if-zero-123/flyctrol/BOM_NAZE32飞控_NAZE32飞控_2026-05-23.xlsx

No. | Quantity | Comment | Designator | Footprint | Value | Manufacturer Part | Manufacturer | Supplier Part | Supplier
1 | 2 | 100nF | C1,C2 | C0603 | 100nF
2 | 2 | 20pF | C3,C7 | C0603 |  | CL10C220JB8NNNC | SAMSUNG | C1653 | LCSC
3 | 2 | 22uF | C4,C5 | C0603 | 22uF
4 | 8 | 0.1uF | C6,C22,C23,C24,C25,C26,C34,C42 | C0603 |  | AC0603KRX7R9BB104 | YAGEO | C149620 | LCSC
5 | 5 | 1uF | C27,C28,C30,C32,C33 | C0603 |  | CC0603KRX5R8BB105 | YAGEO | C14664 | LCSC
6 | 2 | 10uF | C29,C31 | C0603
7 | 1 | 0.01uF | C38 | C0603
8 | 2 | 0.1uF | C39,C41 | C0603
9 | 1 | 2.2nF | C40 | C0603
10 | 4 | PH1250-LT-02 | CN1,CN3,CN4,CN6 | CONN-SMD_2P-P1.25_PH1250-LT-02 |  | PH1250-LT-02 | HOOYA(皓宇电子) | C2939426 | LCSC
11 | 1 | 1.25MM-4P | CN2 | 4P-1.27MM |  | 1.25T-4PVertical patch | BOOMELE | C47608 | LCSC
12 | 1 | BAT54C | D2 | SOT-23-3_L2.9-W1.6-P1.90-LS2.8-BR |  | BAT54C(L43) | SEMTECH | C118748 | LCSC
13 | 1 | 4.7uH | L1 | IND-SMD_L4.6-W4.1-A | 4.7uH | SRG0420-4R7-M | JIERR(捷而瑞) | C53462918 | LCSC
14 | 1 | LED-0603_B | LED4 | LED0603_BLUE |  | 19-217/BHC-ZL1M2RY/3T | EVERLIGHT(台湾亿光) | C72041 | LCSC
15 | 1 | LED-0603_G | LED5 | LED0603_GREEN |  | NCD0805G1 | 国星光电 | C84260
16 | 1 | LED-0603_R | LED6 | LED0603_RED |  | 19-217/R6C-AL1M2VY/3T | EVERLIGHT(台湾亿光) | C72044 | LCSC
17 | 4 | IRLML6344 | Q1,Q2,Q3,Q5 | SOT-23-3_L3.0-W1.7-P0.95-LS2.9-BR |  | IRLML6344 | Hottech(合科泰) | C5364313 | LCSC
18 | 4 | 100K | R1,R3,R5,R7 | R0603 | 100K
19 | 4 | 100 | R2,R4,R6,R8 | R0603 | 100
20 | 4 | 10k | R18,R19,R23,R28 | R0603
21 | 3 | 4K7 | R25,R26,R27 | R0603
22 | 1 | 100k | R29 | R0603
23 | 3 | 1k | R30,R31,R32 | R0603
24 | 1 | Key_SMD_3x4x2 | SW1 | Key_SMD_3x4x2
25 | 4 | M3铜柱 | TP5,TP6,TP7,TP8 | M3铜柱_LCEDA |  |  |  |  | LCSC
26 | 1 | AP63205WU-7 | U1 | TSOT-23-6_L2.9-W1.6-P0.95-LS2.8-BL |  | AP63205WU-7 | DIODES(美台) | C2071056 | LCSC
27 | 1 | ZX-XH2.54-3PWZ | U3 | HDR-TH_3P-P2.50_ZX-XH2.54-3PWZ |  | ZX-XH2.54-3PWZ | Megastar(兆星) | C7429642 | LCSC
28 | 1 | CH340C | U4 | SOP-16_L10.0-W3.9-P1.27-LS6.0-BL |  | CH340C | WCH(南京沁恒) | C84681 | LCSC
29 | 1 | ZX-SH1.0-4PWT | U5 | CONN-SMD_4P-P1.00_MEGASTAR_ZX-SH1.0-4PWT |  | ZX-SH1.0-4PWT | Megastar(兆星) | C7430446 | LCSC
30 | 1 | STM32F103C8T6 | U9 | LQFP-48_L7.0-W7.0-P0.50-LS9.0-BL |  | STM32F103C8T6 | STMicroelectronics | C8734 | LCSC
31 | 2 | RT9013-33GB | U11,U13 | SOT-23-5_L3.0-W1.7-P0.95-LS2.8-BR |  | RT9013-33GB | RICHTEK | C47773 | LCSC
32 | 1 | BMP280 | U12 | SENSOR-TH_BMP280-BL |  | BMP280 | Bosch | C83291 | LCSC
33 | 1 | MPU6050 | U15 | QFN50P400X400X95-25T265X275N
34 | 1 | TYPE-C-16P | USB2 | USB-C-SMD_TYPE-C16PIN |  | TYPE-C16PIN | SHOU HAN | C393939 | LCSC
35 | 1 | 8MHz | X2 | OSC-SMD_3P-L3.2-W1.3-P1.2-L |  | CSTCE8M00G52-R0 | MuRata | C22549 | LCSC
