if-zero-123/flyctrol/SCH_NAZE32飞控_2026-05-23.pdf

3.3V

## GND

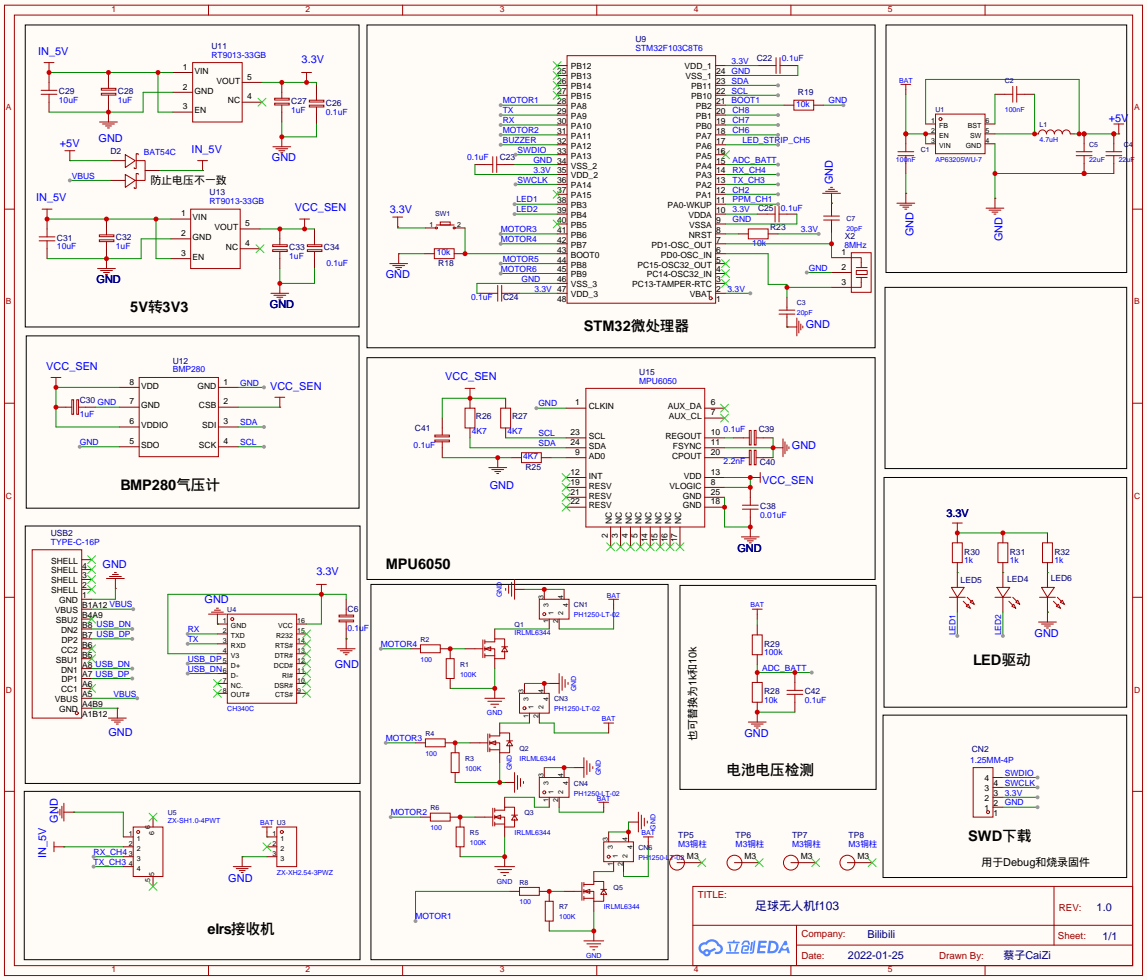
[picture p1: page 1]
