if-zero-123/flyctrol/Core/Src/main.c

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
/* Includes ------------------------------------------------------------------*/
#include "main.h"
/* USER CODE BEGIN Includes */
#include <string.h>
#include "FreeRTOS.h"
#include "task.h"
#include "app_main.h"
/* USER CODE END Includes */

ADC_HandleTypeDef hadc1;

I2C_HandleTypeDef hi2c2;

TIM_HandleTypeDef htim1;
TIM_HandleTypeDef htim4;

UART_HandleTypeDef huart1;
UART_HandleTypeDef huart2;
DMA_HandleTypeDef hdma_usart2_rx;
void SystemClock_Config(void);
static void MX_GPIO_Init(void);
static void MX_DMA_Init(void);
static void MX_ADC1_Init(void);
static void MX_I2C2_Init(void);
static void MX_TIM1_Init(void);
static void MX_TIM4_Init(void);
static void MX_USART1_UART_Init(void);
static void MX_USART2_UART_Init(void);
/* USER CODE BEGIN PFP */
static void StartupTask(void *argument);

/* USER CODE END PFP */

/* USER CODE BEGIN 0 */
static volatile uint32_t s_boot_stage;
static volatile uint32_t s_clock_hsi_fallback;

static void EarlyUart1_InitBare(void)
{
  uint32_t pclk;

  RCC->APB2ENR |= RCC_APB2ENR_AFIOEN | RCC_APB2ENR_IOPAEN | RCC_APB2ENR_USART1EN;

  GPIOA->CRH &= ~((0xFU << 4U) | (0xFU << 8U));
  GPIOA->CRH |= (0xBU << 4U) | (0x4U << 8U); /* PA9 AF_PP, PA10 floating input */

  USART1->CR1 = 0U;
  pclk = HAL_RCC_GetPCLK2Freq();
  if (pclk < 1000000U)
  {
    pclk = 8000000U;
  }
  USART1->BRR = (pclk + (115200U / 2U)) / 115200U;
  USART1->CR1 = USART_CR1_TE | USART_CR1_RE | USART_CR1_UE;
}

static void EarlyUart1_WriteString(const char *text)
{
  if (text == NULL)
  {
    return;
  }
  while (*text != '\0')
  {
    while ((USART1->SR & USART_SR_TXE) == 0U)
    {
    }
    USART1->DR = (uint16_t)(uint8_t)(*text++);
  }
  while ((USART1->SR & USART_SR_TC) == 0U)
  {
  }
}

static void EarlyDelay(volatile uint32_t loops)
{
  while (loops-- > 0U)
  {
  }
}

static void EarlyLed_InitBare(void)
{
  RCC->APB2ENR |= RCC_APB2ENR_AFIOEN | RCC_APB2ENR_IOPBEN;
  MODIFY_REG(AFIO->MAPR, AFIO_MAPR_SWJ_CFG, AFIO_MAPR_SWJ_CFG_JTAGDISABLE);

  GPIOB->CRL &= ~((0xFU << (3U * 4U)) | (0xFU << (4U * 4U)));
  GPIOB->CRL |= (0x2U << (3U * 4U)) | (0x2U << (4U * 4U)); /* output push-pull 2 MHz */
  GPIOB->BSRR = GPIO_PIN_3 | GPIO_PIN_4;                   /* active-low LEDs off */
}

static void EarlyLed_Set(uint16_t pin, uint32_t on)
{
  GPIOB->BSRR = (on != 0U) ? ((uint32_t)pin << 16U) : pin;
}

static void EarlyLed_BootFlash(void)
{
  for (uint32_t i = 0U; i < 4U; i++)
  {
    EarlyLed_Set(GPIO_PIN_3, 1U);
    EarlyLed_Set(GPIO_PIN_4, 1U);
    EarlyDelay(700000U);
    EarlyLed_Set(GPIO_PIN_3, 0U);
    EarlyLed_Set(GPIO_PIN_4, 0U);
    EarlyDelay(700000U);
  }
}

static void EarlyLed_ClockFlash(void)
{
  for (uint32_t i = 0U; i < 4U; i++)
  {
    EarlyLed_Set(GPIO_PIN_3, 1U);
    EarlyLed_Set(GPIO_PIN_4, 0U);
    EarlyDelay(500000U);
    EarlyLed_Set(GPIO_PIN_3, 0U);
    EarlyLed_Set(GPIO_PIN_4, 1U);
    EarlyDelay(500000U);
  }
  EarlyLed_Set(GPIO_PIN_3, 0U);
  EarlyLed_Set(GPIO_PIN_4, 0U);
}

static void EarlyLed_ClockResultHold(uint32_t hsi_fallback)
{
  uint16_t on_pin = (hsi_fallback != 0U) ? GPIO_PIN_3 : GPIO_PIN_4;
  uint16_t off_pin = (hsi_fallback != 0U) ? GPIO_PIN_4 : GPIO_PIN_3;

  EarlyDelay(1200000U);
  EarlyLed_Set(on_pin, 1U);
  EarlyLed_Set(off_pin, 0U);
  for (uint32_t i = 0U; i < 8U; i++)
  {
    EarlyDelay(1000000U);
  }
  EarlyLed_Set(on_pin, 0U);
  EarlyDelay(1200000U);
}

static void EarlyLed_ErrorCode(uint32_t code)
{
  uint32_t tens = code / 10U;
  uint32_t ones = code % 10U;

  EarlyLed_Set(GPIO_PIN_3, 0U);
  EarlyLed_Set(GPIO_PIN_4, 0U);
  EarlyDelay(2500000U);

  for (uint32_t i = 0U; i < tens; i++)
  {
    EarlyLed_Set(GPIO_PIN_4, 1U);
    EarlyDelay(700000U);
    EarlyLed_Set(GPIO_PIN_4, 0U);
    EarlyDelay(700000U);
  }

  EarlyDelay(1400000U);

  for (uint32_t i = 0U; i < ones; i++)
  {
    EarlyLed_Set(GPIO_PIN_3, 1U);
    EarlyDelay(700000U);
    EarlyLed_Set(GPIO_PIN_3, 0U);
    EarlyDelay(700000U);
  }
}

static uint32_t StackOverflowStageFromName(const char *name)
{
  if (name == NULL)
  {
    return 31U;
  }
  if (strcmp(name, "stabilize") == 0)
  {
    return 62U;
  }
  if (strcmp(name, "startup") == 0)
  {
    return 61U;
  }
  if (strcmp(name, "crsf") == 0)
  {
    return 63U;
  }
  if (strcmp(name, "safety") == 0)
  {
    return 64U;
  }
  if (strcmp(name, "baro") == 0)
  {
    return 65U;
  }
  if (strcmp(name, "battery") == 0)
  {
    return 66U;
  }
  if (strcmp(name, "telem") == 0)
  {
    return 67U;
  }
  if (strcmp(name, "cli") == 0)
  {
    return 68U;
  }
  return 31U;
}

/* USER CODE END 0 */

/**
  * @brief  The application entry point.
  * @retval int
  */
int main(void)
{

  /* USER CODE BEGIN 1 */
  s_boot_stage = 1U;

  /* USER CODE END 1 */

  /* MCU Configuration--------------------------------------------------------*/

  /* Reset of all peripherals, Initializes the Flash interface and the Systick. */
  HAL_Init();

  /* USER CODE BEGIN Init */
  EarlyLed_InitBare();
  EarlyLed_BootFlash();
  EarlyUart1_InitBare();
  EarlyUart1_WriteString("\r\nPRECLK USART1 115200 PA9_TX PA10_RX\r\n");

  /* USER CODE END Init */

  /* Configure the system clock */
  s_boot_stage = 2U;
  SystemClock_Config();

  /* USER CODE BEGIN SysInit */
  EarlyLed_InitBare();
  EarlyLed_ClockFlash();
  EarlyLed_ClockResultHold(s_clock_hsi_fallback);
  EarlyUart1_InitBare();
  if (s_clock_hsi_fallback != 0U)
  {
    EarlyUart1_WriteString("CLOCK OK HSI FALLBACK SYSCLK\r\n");
  }
  else
  {
    EarlyUart1_WriteString("CLOCK OK HSE PLL SYSCLK\r\n");
  }

  /* USER CODE END SysInit */

  /* Initialize all configured peripherals */
  s_boot_stage = 3U;
  MX_GPIO_Init();
  s_boot_stage = 4U;
  MX_USART1_UART_Init();
  /* USER CODE BEGIN 2 */
  {
    const uint8_t early_msg[] = "HAL USART1 OK 115200\r\n";
    (void)HAL_UART_Transmit(&huart1, (uint8_t *)early_msg, sizeof(early_msg) - 1U, 200U);
  }

  /* USER CODE END 2 */
  s_boot_stage = 5U;
  MX_DMA_Init();
  s_boot_stage = 6U;
  MX_ADC1_Init();
  s_boot_stage = 7U;
  MX_I2C2_Init();
  s_boot_stage = 8U;
  MX_TIM1_Init();
  s_boot_stage = 9U;
  MX_TIM4_Init();
  s_boot_stage = 10U;
  MX_USART2_UART_Init();

  /* USER CODE BEGIN RTOS_MUTEX */
  /* add mutexes, ... */
  /* USER CODE END RTOS_MUTEX */

  /* USER CODE BEGIN RTOS_SEMAPHORES */
  /* add semaphores, ... */
  /* USER CODE END RTOS_SEMAPHORES */

  /* USER CODE BEGIN RTOS_TIMERS */
  /* start timers, add new ones, ... */
  /* USER CODE END RTOS_TIMERS */

  /* USER CODE BEGIN RTOS_QUEUES */
  /* add queues, ... */
  /* USER CODE END RTOS_QUEUES */

  /* Create a small startup task so App_Start runs with the RTOS alive. */
  s_boot_stage = 11U;
  if (xTaskCreate(StartupTask,
                  "startup",
                  256U,
                  NULL,
                  tskIDLE_PRIORITY + 1U,
                  NULL) != pdPASS)
  {
    Error_Handler();
  }

  /* USER CODE BEGIN RTOS_THREADS */
  /* add threads, ... */
  /* USER CODE END RTOS_THREADS */

  /* Start scheduler */
  s_boot_stage = 12U;
  vTaskStartScheduler();

  /* We should never get here as control is now taken by the scheduler */

  /* Infinite loop */
  /* USER CODE BEGIN WHILE */
  while (1)
  {
    /* USER CODE END WHILE */

    /* USER CODE BEGIN 3 */
  }
  /* USER CODE END 3 */
}

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
/* USER CODE BEGIN 4 */
static void StartupTask(void *argument)
{
  (void)argument;
  s_boot_stage = 20U;
  App_Start();
  s_boot_stage = 21U;
  vTaskDelete(NULL);
  for (;;)
  {
  }
}

void AppBootStage_Set(uint32_t stage)
{
  s_boot_stage = stage;
}

uint32_t AppClock_IsHsiFallback(void)
{
  return s_clock_hsi_fallback;
}

void vApplicationMallocFailedHook(void)
{
  s_boot_stage = 30U;
  taskDISABLE_INTERRUPTS();
  EarlyLed_InitBare();
  for (;;)
  {
    EarlyLed_ErrorCode(s_boot_stage);
  }
}

void vApplicationStackOverflowHook(TaskHandle_t xTask, char *pcTaskName)
{
  (void)xTask;
  s_boot_stage = StackOverflowStageFromName(pcTaskName);
  taskDISABLE_INTERRUPTS();
  EarlyLed_InitBare();
  for (;;)
  {
    EarlyLed_ErrorCode(s_boot_stage);
  }
}

/* USER CODE END 4 */

/**
  * @brief  Period elapsed callback in non blocking mode
  * @note   This function is called  when TIM2 interrupt took place, inside
  * HAL_TIM_IRQHandler(). It makes a direct call to HAL_IncTick() to increment
  * a global variable "uwTick" used as application time base.
  * @param  htim : TIM handle
  * @retval None
  */
void HAL_TIM_PeriodElapsedCallback(TIM_HandleTypeDef *htim)
{
  if (htim->Instance == TIM2)
  {
    HAL_IncTick();
  }
}

/**
  * @brief  This function is executed in case of error occurrence.
  * @retval None
  */
void Error_Handler(void)
{
  /* USER CODE BEGIN Error_Handler_Debug */
  /* User can add his own implementation to report the HAL error return state */
  __disable_irq();
  EarlyUart1_InitBare();
  EarlyLed_InitBare();
  while (1)
  {
    EarlyUart1_WriteString("ERROR_HANDLER stage=");
    char stage_text[12];
    uint32_t v = s_boot_stage;
    uint32_t pos = 0U;
    if (v >= 100U)
    {
      stage_text[pos++] = (char)('0' + ((v / 100U) % 10U));
    }
    if (v >= 10U)
    {
      stage_text[pos++] = (char)('0' + ((v / 10U) % 10U));
    }
    stage_text[pos++] = (char)('0' + (v % 10U));
    stage_text[pos++] = '\r';
    stage_text[pos++] = '\n';
    stage_text[pos] = '\0';
    EarlyUart1_WriteString(stage_text);
    EarlyLed_ErrorCode(s_boot_stage);
  }
  /* USER CODE END Error_Handler_Debug */
}

#ifdef  USE_FULL_ASSERT
/**
  * @brief  Reports the name of the source file and the source line number
  *         where the assert_param error has occurred.
  * @param  file: pointer to the source file name
  * @param  line: assert_param error line source number
  * @retval None
  */
void assert_failed(uint8_t *file, uint32_t line)
{
  /* USER CODE BEGIN 6 */
  /* User can add his own implementation to report the file name and line number,
     ex: printf("Wrong parameters value: file %s on line %d\r\n", file, line) */
  /* USER CODE END 6 */
}
#endif /* USE_FULL_ASSERT */
