if-zero-123/flyctrol/flyctrol.ioc

Mcu.UserName=STM32F103C8Tx
PA10.Signal=USART1_RX
PA11.Signal=S_TIM1_CH4
PA13.Signal=SYS_JTMS-SWDIO
PA14.Signal=SYS_JTCK-SWCLK
PA2.Signal=USART2_TX
PA3.Signal=USART2_RX
PA4.Signal=ADCx_IN4
PA8.Signal=S_TIM1_CH1
PA9.Signal=USART1_TX
PB10.Signal=I2C2_SCL
PB11.Signal=I2C2_SDA
PB3.GPIO_Label=LED1_GREEN
PB3.Signal=GPIO_Output
PB4.GPIO_Label=LED2_BLUE
PB4.Signal=GPIO_Output
PB6.Signal=S_TIM4_CH1
PB7.Signal=S_TIM4_CH2
PD0-OSC_IN.Signal=RCC_OSC_IN
PD1-OSC_OUT.Signal=RCC_OSC_OUT
