if-zero-123/flyctrol/Core/Inc/main.h

#define LED1_GREEN_Pin GPIO_PIN_3
#define LED1_GREEN_GPIO_Port GPIOB
#define LED2_BLUE_Pin GPIO_PIN_4
#define LED2_BLUE_GPIO_Port GPIOB
