if-zero-123/flyctrol/App/modules/safety.h

#ifndef APP_SAFETY_H
#define APP_SAFETY_H

#include <stdbool.h>
#include <stdint.h>
#include "flight_types.h"

#define SAFETY_FAILSAFE_RC      0x0001U
#define SAFETY_FAILSAFE_IMU     0x0002U
#define SAFETY_FAILSAFE_BATTERY 0x0004U
#define SAFETY_FAILSAFE_CRASH   0x0008U
#define SAFETY_ARM_BLOCK_RC       0x0001U
#define SAFETY_ARM_BLOCK_IMU      0x0002U
#define SAFETY_ARM_BLOCK_BATTERY  0x0004U
#define SAFETY_ARM_BLOCK_THROTTLE 0x0008U
#define SAFETY_ARM_BLOCK_LEVEL    0x0010U
#define SAFETY_ARM_BLOCK_LATCH    0x0020U
#define SAFETY_ARM_BLOCK_CRASH    0x0040U
#define SAFETY_DISARM_ARM_LOST  0x0100U
#define SAFETY_DISARM_CRASH     0x0200U

void Safety_Init(void);
void Safety_Update(void);
bool Safety_CanRunMotors(void);
bool Safety_CanMotorTest(void);
void Safety_RequestArm(bool enable);
void Safety_RequestDisarm(void);
void Safety_MotorTestUnlock(uint32_t window_ms);
void Safety_MotorTestBenchUnlock(uint32_t window_ms);
flight_status_t Safety_GetStatus(void);

#endif /* APP_SAFETY_H */
