if-zero-123/flyctrol/(commit log)

2026-05-24 Initial flight firmware workspace
    [BOM_NAZE32飞控_NAZE32飞控_2026-05-23.xlsx]
2026-05-24 验证时钟开启
2026-05-25 优化飞控串口CLI和调试上位机交互
2026-05-25 校准2S电池ADC检测
2026-05-25 修复启动阶段串口和故障定位
2026-05-25 增加电池ADC诊断命令
2026-05-25 修正QuadX混控并输出电机映射
2026-05-25 加入BF式电机怠速和混控保护
2026-05-25 补充IMU水平校准命令
2026-05-25 修复飞行中IMU重初始化阻塞
2026-05-25 增加电池保护去抖和停机日志
2026-05-25 修复飞控混控和空中停机逻辑
2026-05-25 避免上位机误连FAKE演示串口
2026-05-25 增加IMU瞬时读失败容错
2026-05-25 修正控制诊断状态覆盖
2026-05-25 修正偏航陀螺方向
2026-05-25 增加基础滤波和飞行调试限幅
2026-05-25 迁移BF风格姿态控制内环
2026-05-25 限制首飞油门并修正低油门混控
2026-05-25 解锁低油门仅保持电机怠速
2026-05-25 降低首飞姿态灵敏度和PID
2026-05-25 拆分解锁阻止和飞行失控标志
2026-05-25 增加飞行后摘要诊断
2026-05-25 增强解锁鲁棒性并提升操控响应
2026-05-25 限制混控差分防止半油门饱和翻机
2026-05-25 优化悬停油门曲线和操控手感
2026-05-25 加入BF式I项防风up
2026-05-25 加入Mahony姿态解算和IMU滤波
2026-05-25 加入AirMode混控和撞击保护
2026-05-25 清理撞击后飞控状态并提升响应
2026-05-25 优化定高估计和高度保持控制
2026-05-25 显示定高准备状态到上位机
2026-05-25 修复定高监控刷新崩溃
2026-05-25 增强定高鲁棒性并放宽误停保护
2026-05-25 融合IMU气压高度并支持定高起飞
2026-05-25 降低内存压力并避免空中误停
2026-05-25 修复FreeRTOS任务创建heap不足
2026-05-25 静态创建飞控任务避免heap启动失败
2026-05-25 Revert "静态创建飞控任务避免heap启动失败"
    This reverts commit 167a612d84e386239cdb91ca57a9efad5d313315.
    [app_tasks.c, main.c]
2026-05-25 Revert "修复FreeRTOS任务创建heap不足"
    This reverts commit 03caaf8138062bb388f4b9580d3b639202014797.
2026-05-25 Revert "降低内存压力并避免空中误停"
    This reverts commit 257693ae85ae9640f3a36b7b7a7a79e4c246b740.
    [app_tasks.c, board_config.h, cli.c, debug_uart.c, flight_monitor.c, main.c, safety.c]
2026-05-25 保守诊断空中停机并优化定高响应
2026-05-26 修复任务创建阶段heap不足
2026-05-26 移除默认任务启动器避免抢占heap
2026-05-26 修复启动任务栈路径和运行灯心跳
2026-05-26 彻底降低启动内存压力修复53灯码
2026-05-26 修复高优先级任务饿死运行灯
2026-05-26 延后传感器初始化确保调度器先启动
2026-05-26 稳定启动并优化定高解锁逻辑
2026-05-26 修正定高基础推力避免上冲
2026-05-26 简化定高油门控制逻辑
2026-05-26 实现速度杆定高并修复启动时序
2026-05-26 实现玩具机弱定高辅助
2026-05-26 重写BMP280+IMU串级定高
2026-05-26 修复定高起飞冲高和下降权限
2026-05-26 校准加速度计以稳定定高估计
2026-05-26 修复未解锁时气压热漂导致高度跑飞
2026-05-26 增加气压计原始相对高度调试输出
2026-05-26 调软玩具机定高和姿态控制
2026-05-26 修复早离地后定高爬升受限
2026-05-26 优化定高模式横向慢漂诊断
2026-05-27 修复慢漂诊断导致的启动HardFault
2026-05-27 放开定高模式横向控制手感
